TabitaMittanck/tcc-monitoramento-qualidade-agua/hardware/esquematico_tcc.kicad_sch

## KiCad design hardware/esquematico_tcc.kicad_sch (2026-10-02)

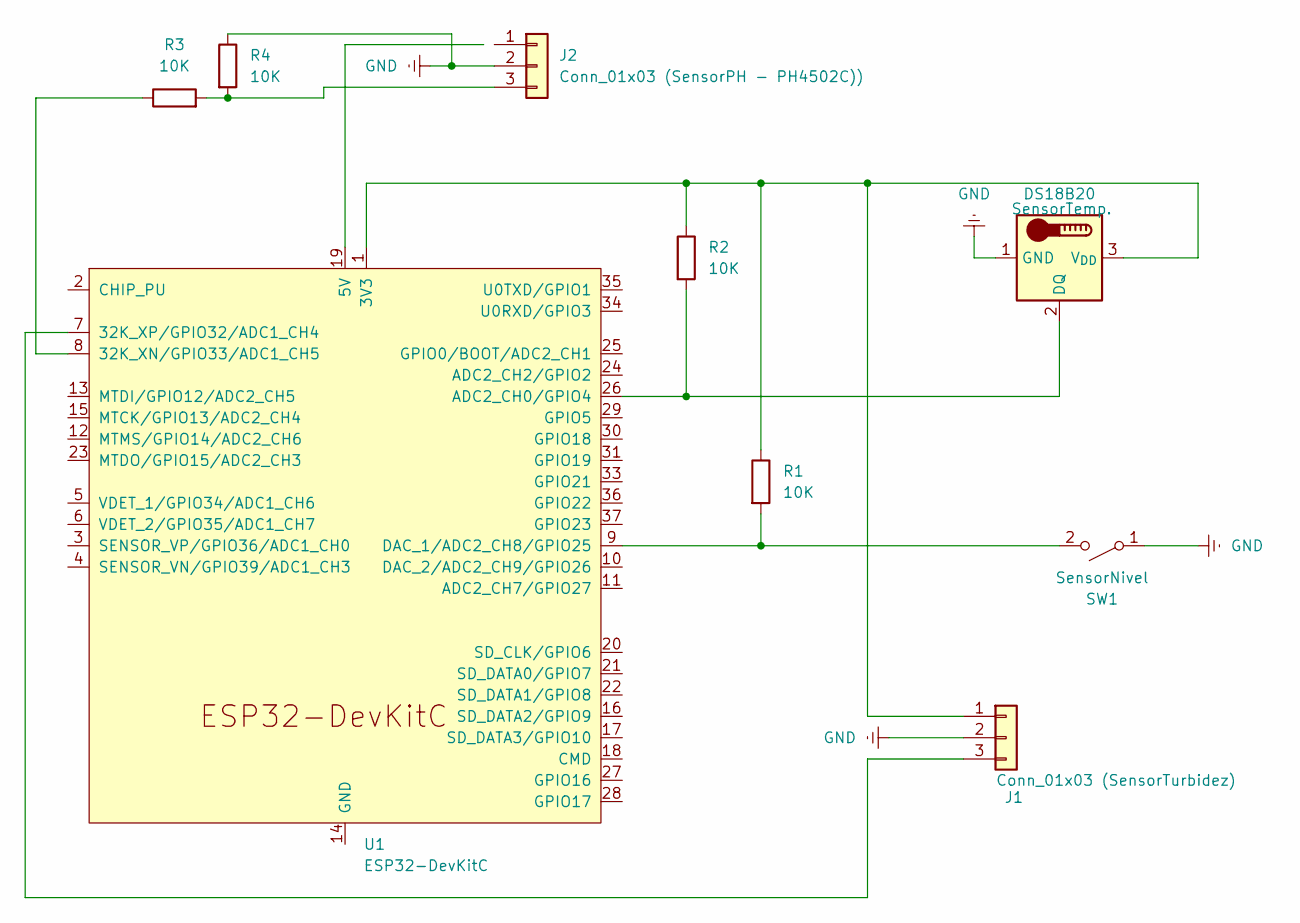
[picture p4: schematic esquematico_tcc.kicad_sch]

Parts:
J1: Conn_01x03 (SensorTurbidez)
J2: Conn_01x03 (SensorPH - PH4502C))
R1, R2, R3, R4: 10K
SW1: SensorNivel
SensorTemp.: DS18B20; TO-92_Inline
U1: ESP32-DevKitC

Connections:
GND: J1.2 (GND), J2.2 (GND), R4.1, SW1.1 (A), SensorTemp..1 (GND)
unnamed: J1.1 (VCC), R1.1, R2.1, SensorTemp..3 (V_{DD}), U1.1 (3V3)
unnamed: J1.3 (AO), U1.7 (32K_XP/GPIO32/ADC1_CH4)
unnamed: J2.3 (AO), R3.2, R4.2
unnamed: R1.2, SW1.2 (B), U1.9 (DAC_1/ADC2_CH8/GPIO25)
unnamed: R2.2, SensorTemp..2 (DQ), U1.26 (ADC2_CH0/GPIO4)
unnamed: R3.1, U1.8 (32K_XN/GPIO33/ADC1_CH5)
unnamed: U1.14 (GND), U1.32 (GND), U1.38 (GND)
