TabitaMittanck/tcc-monitoramento-qualidade-agua/(notices)

Notices in the files:
README.md:
License: MIT
